ca-course-new/risc-v/(list of files, cad)

Other CAD files:
rv32i_modelsim/work/dff16bit/verilog.psm
rv32i_modelsim/work/dff1bit/verilog.psm
rv32i_modelsim/work/dff2bit/verilog.psm
rv32i_modelsim/work/dff32bit/verilog.psm
rv32i_modelsim/work/dff4bit/verilog.psm
rv32i_modelsim/work/dff8bit/verilog.psm
rv32i_modelsim/work/rv32i_@a@l@u/verilog.psm
rv32i_modelsim/work/rv32i_adder32bit/verilog.psm
rv32i_modelsim/work/rv32i_br@addr@calc/verilog.psm
rv32i_modelsim/work/rv32i_control/verilog.psm
rv32i_modelsim/work/rv32i_cpu/verilog.psm
rv32i_modelsim/work/rv32i_data@sel/verilog.psm
rv32i_modelsim/work/rv32i_dff1bit/verilog.psm
rv32i_modelsim/work/rv32i_dff32bit/verilog.psm
rv32i_modelsim/work/rv32i_dff6bit/verilog.psm
rv32i_modelsim/work/rv32i_dram2@k@b/verilog.psm
rv32i_modelsim/work/rv32i_dram4@k@b/verilog.psm
rv32i_modelsim/work/rv32i_forwarding/verilog.psm
rv32i_modelsim/work/rv32i_irom8k_ver2/verilog.psm
rv32i_modelsim/work/rv32i_j@addr@calc/verilog.psm
rv32i_modelsim/work/rv32i_meminfo_display/verilog.psm
rv32i_modelsim/work/rv32i_mux32/verilog.psm
rv32i_modelsim/work/rv32i_mux32bit4ch/verilog.psm
rv32i_modelsim/work/rv32i_nop@insert/verilog.psm
rv32i_modelsim/work/rv32i_pc@sel/verilog.psm
rv32i_modelsim/work/rv32i_ram@sel/verilog.psm
rv32i_modelsim/work/rv32i_ram@write@control/verilog.psm
rv32i_modelsim/work/rv32i_reg@file/verilog.psm
rv32i_modelsim/work/rv32i_stall/verilog.psm
