ca-course-new/risc-v/schematics.pdf

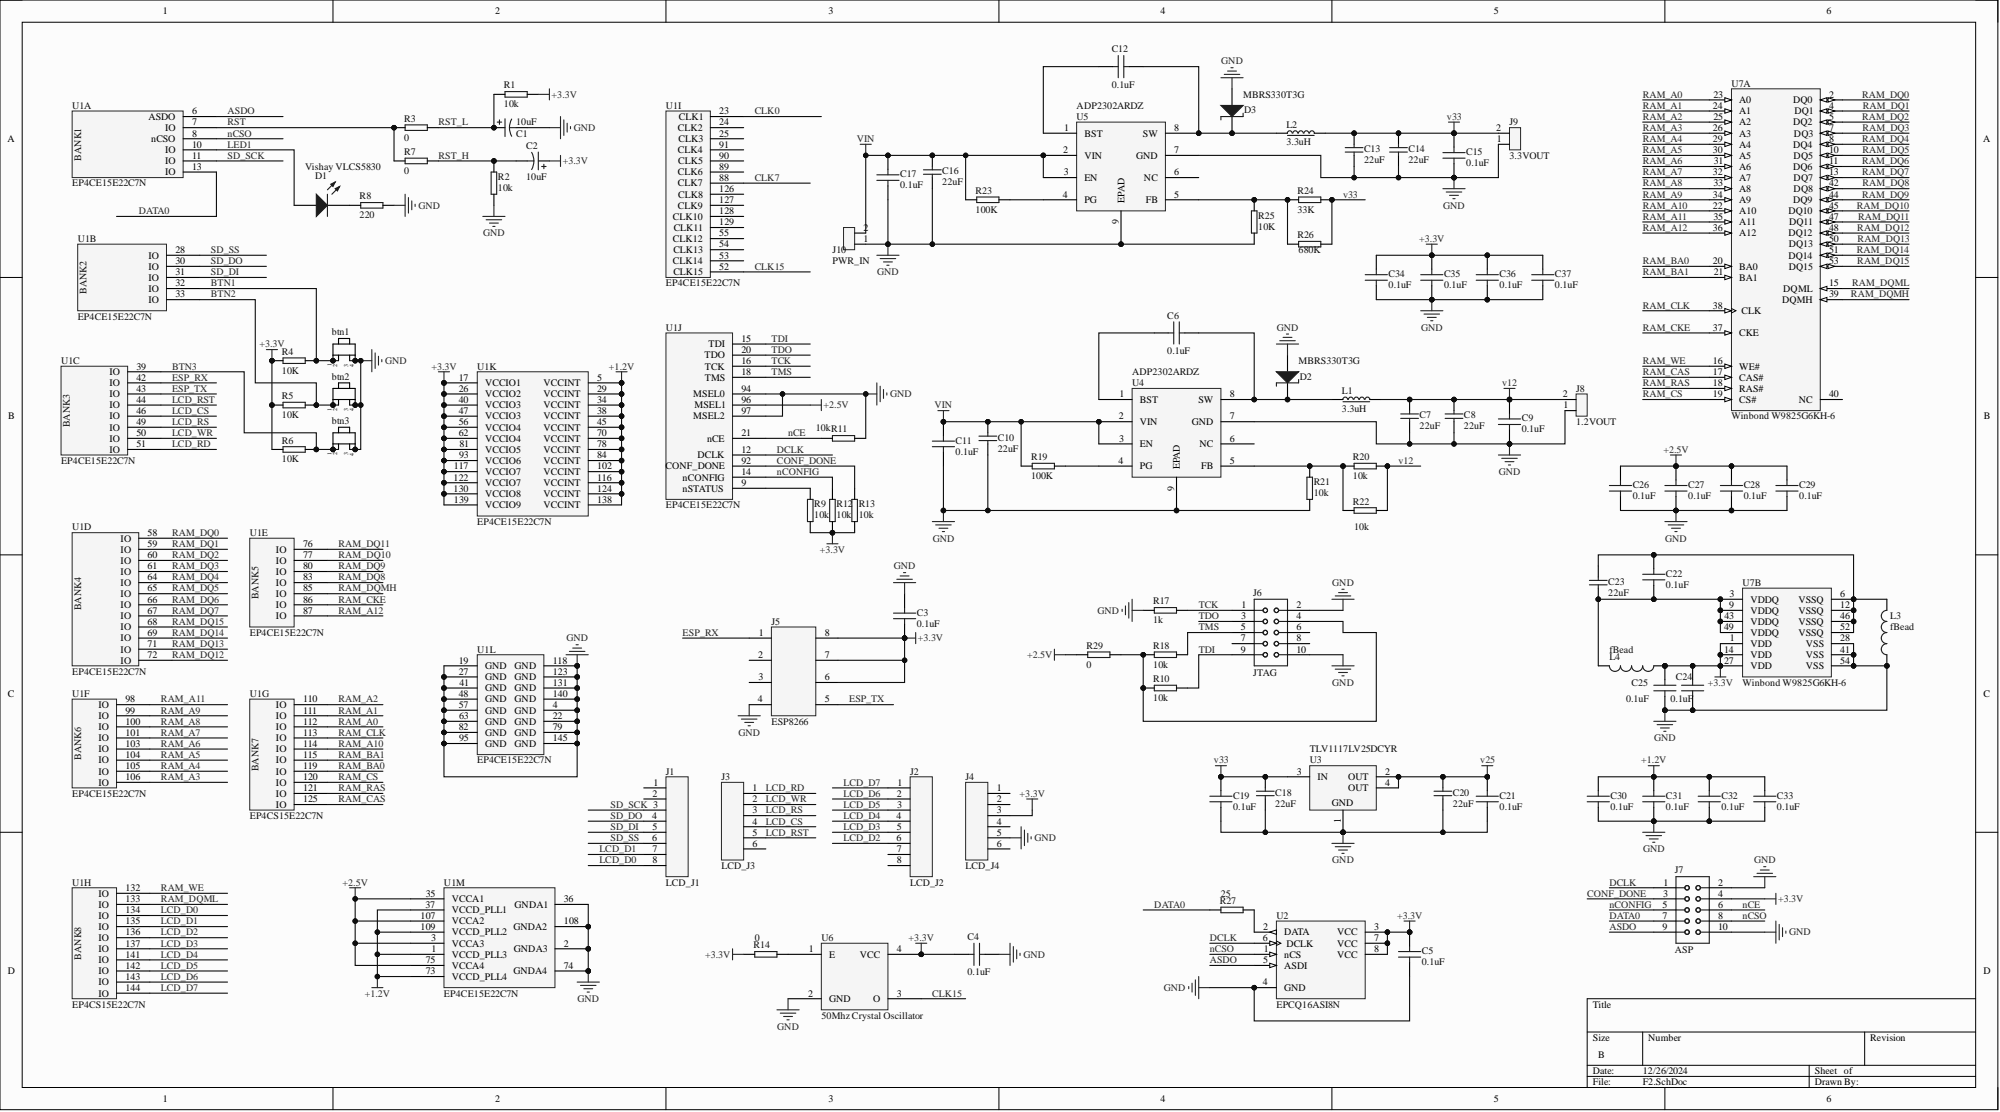
[picture p1: page 1]
