ca-course-new/risc-v/pcb.pdf

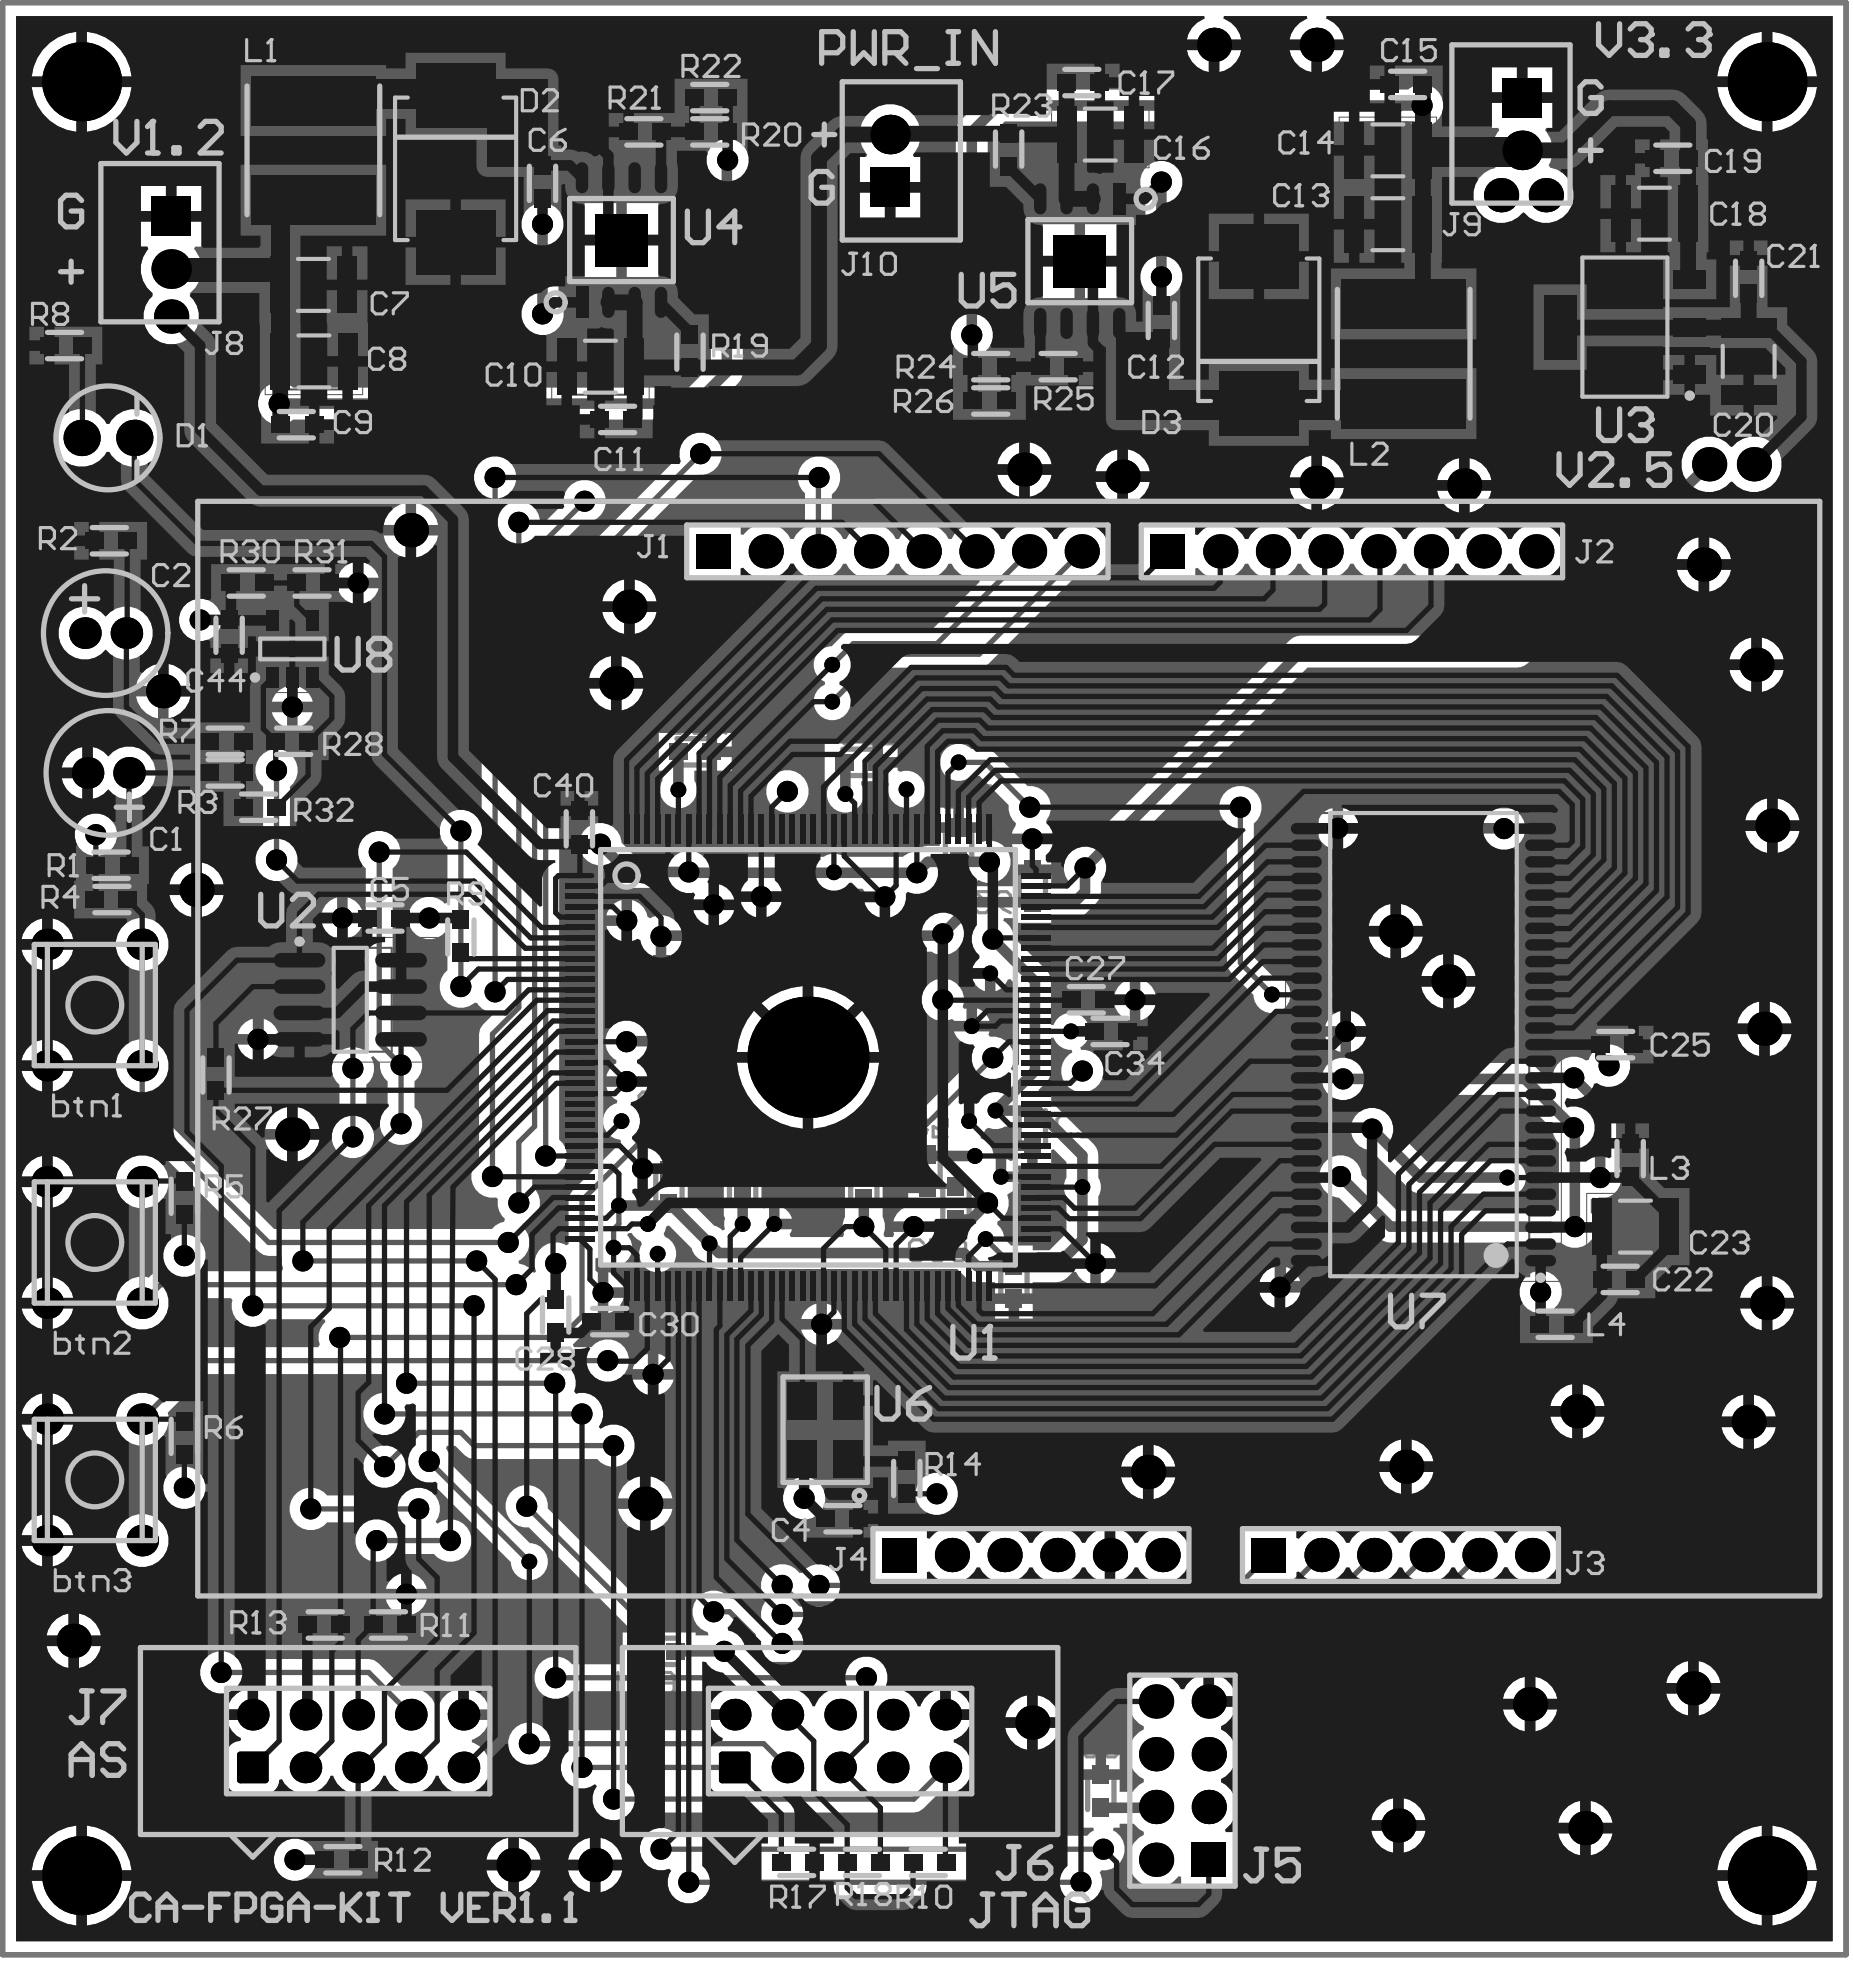
[picture p2: page 1]
