ca-course-new/risc-v/rv32i_modelsim/rv32i_ramSel.v

//Little Endian
//instruction memory only support read
module rv32i_ramSel(irData, drData4K, drData2K, cpuAddr, funct3, out);

input[31:0] irData, drData4K, drData2K;
input[31:0] cpuAddr;
input[2:0] funct3;

output reg [31:0] out;

always @(cpuAddr, funct3, irData, drData4K, drData2K)
begin
	if(cpuAddr[31:15]==17'h00000) //address space of iram 32'h00000000 to 32'h00007FFF, 2^15 bytes (32KB or 8KW)
	begin
		case(funct3)
		3'b000://LB
		begin
			case(cpuAddr[1:0])
			2'b00: //right most byte
			begin
				out<=(irData[7])?{24'hFFFFFF, irData[7:0]}:{24'h000000, irData[7:0]};
			end
			2'b01: //middle right byte
			begin
				out<=(irData[15])?{24'hFFFFFF, irData[15:8]}:{24'h000000, irData[15:8]};
			end
			2'b10: //middle left byte
			begin
				out<=(irData[23])?{24'hFFFFFF, irData[23:16]}:{24'h000000, irData[23:16]};
			end
			2'b11: //left most byte
			begin
				out<=(irData[31])?{24'hFFFFFF, irData[31:24]}:{24'h000000, irData[31:24]};
			end
			endcase
		end
		3'b001://LH: alignment is required
		begin
			if(cpuAddr[1]==0)//lower half
			begin
				out<=(irData[15])?{16'hFFFF, irData[15:0]}:{16'h0000, irData[15:0]};
			end
			else//upper half
			begin
				out<=(irData[31])?{16'hFFFF, irData[31:16]}:{16'h0000, irData[31:16]};
			end
		end
		3'b010://LW: alignment is required
		begin
			out<=irData;
		end
		3'b100://LBU
		begin
			case(cpuAddr[1:0])
			2'b00: //right most byte
			begin
				out<={24'h000000, irData[7:0]};
			end
			2'b01: //middle right byte
			begin
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
		begin
			if(cpuAddr[1]==0)//lower half
			begin
				out<={16'h0000, drData2K[15:0]};
			end
			else//upper half
			begin
				out<={16'h0000, drData2K[31:16]};
			end
		end
		default: //illegal load
		begin
			out<=32'bz;
		end
		endcase
	end
	else
	begin
		out<=32'bz;
	end	
end

endmodule
