ca-course-new/risc-v/rv32i_modelsim/work/dff2bit/_primary.vhd

library verilog;
use verilog.vl_types.all;
entity dff2bit is
    port(
        clk             : in     vl_logic;
        rst             : in     vl_logic;
        \in\            : in     vl_logic_vector(1 downto 0);
        \out\           : out    vl_logic_vector(1 downto 0)
    );
end dff2bit;
