ca-course-new/risc-v/rv32i_modelsim/work/rv32i_adder32bit/_primary.vhd

library verilog;
use verilog.vl_types.all;
entity rv32i_adder32bit is
    port(
        in1             : in     vl_logic_vector(31 downto 0);
        in2             : in     vl_logic_vector(31 downto 0);
        \out\           : out    vl_logic_vector(31 downto 0)
    );
end rv32i_adder32bit;
