ca-course-new/risc-v/rv32i_modelsim/work/rv32i_mux32/_primary.vhd

library verilog;
use verilog.vl_types.all;
entity rv32i_mux32 is
    port(
        in0             : in     vl_logic_vector(31 downto 0);
        in1             : in     vl_logic_vector(31 downto 0);
        sel             : in     vl_logic;
        \out\           : out    vl_logic_vector(31 downto 0)
    );
end rv32i_mux32;
